alyhamdy879/bi-directional-visitor-counter/schematics/3D Visualization (back) .jpeg

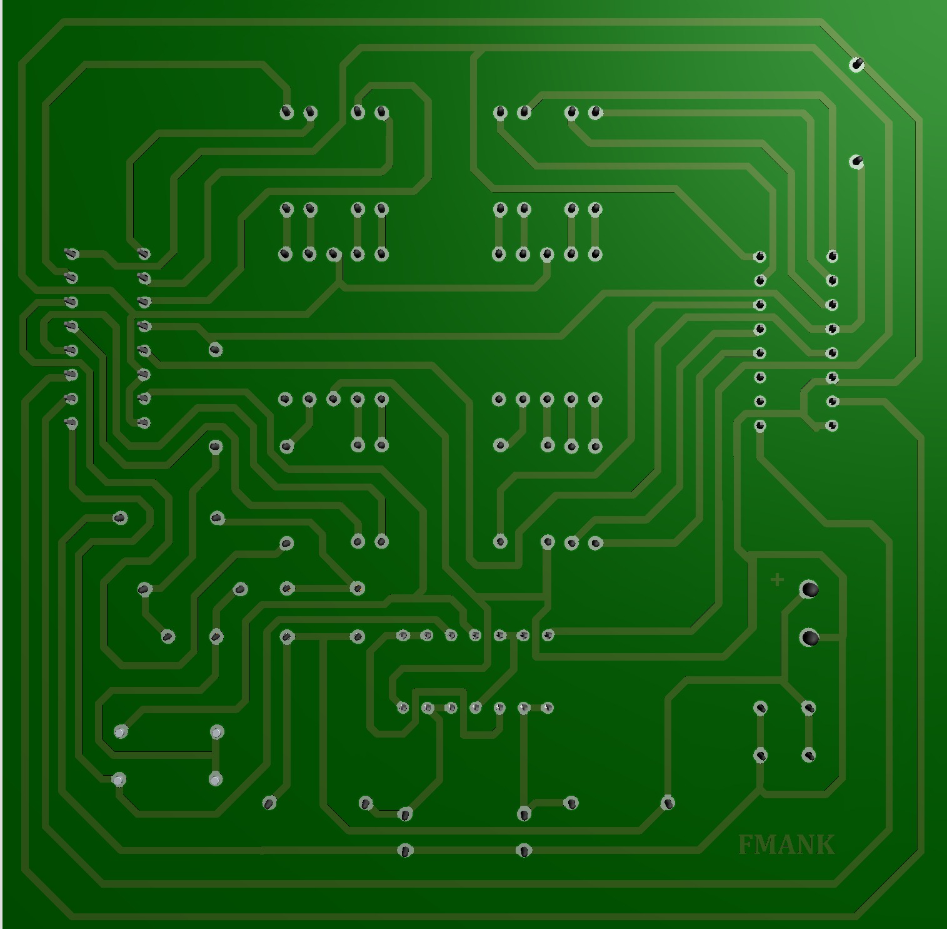
schematics/3D Visualization (back) .jpeg
