alyhamdy879/bi-directional-visitor-counter/schematics/3D Visualization (front).jpeg

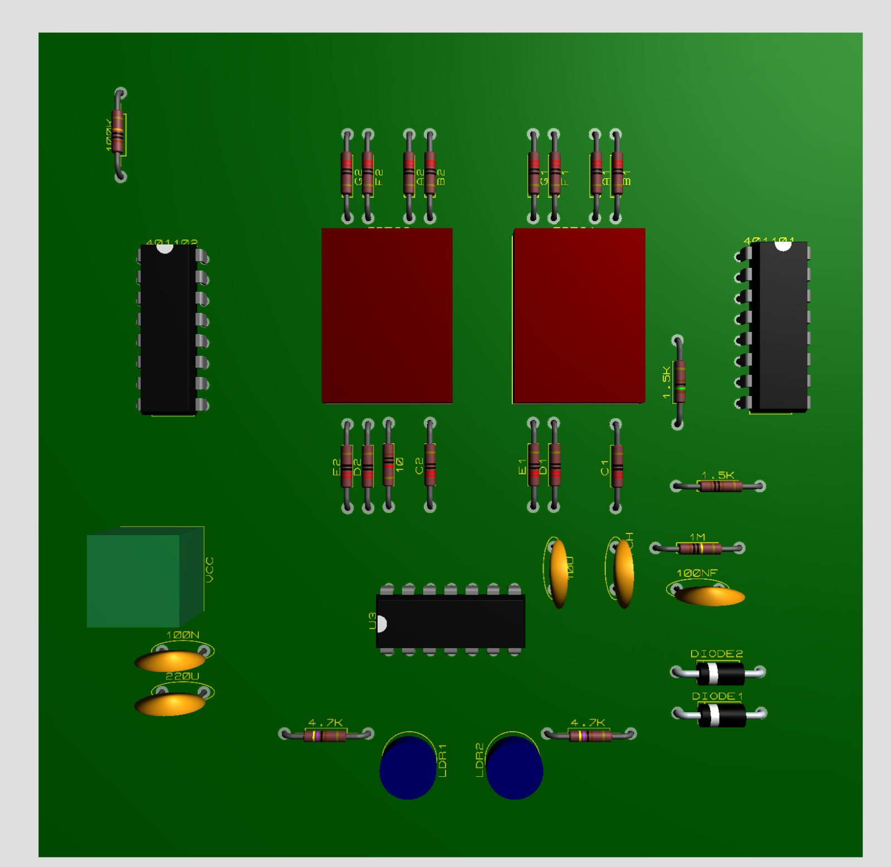
schematics/3D Visualization (front).jpeg
