alyhamdy879/bi-directional-visitor-counter/schematics/layout export .jpeg

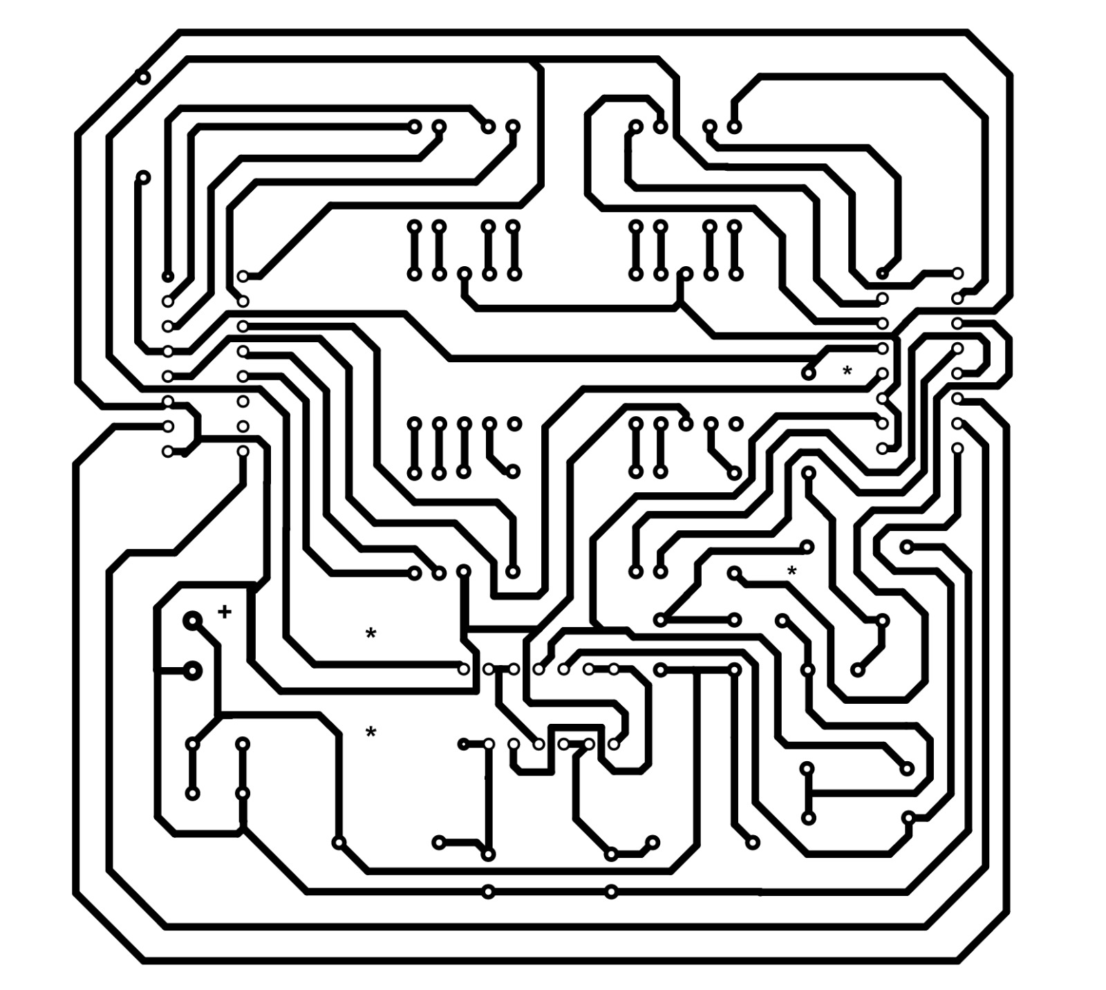
schematics/layout export .jpeg
