alyhamdy879/bi-directional-visitor-counter/schematics/schematic.jpeg

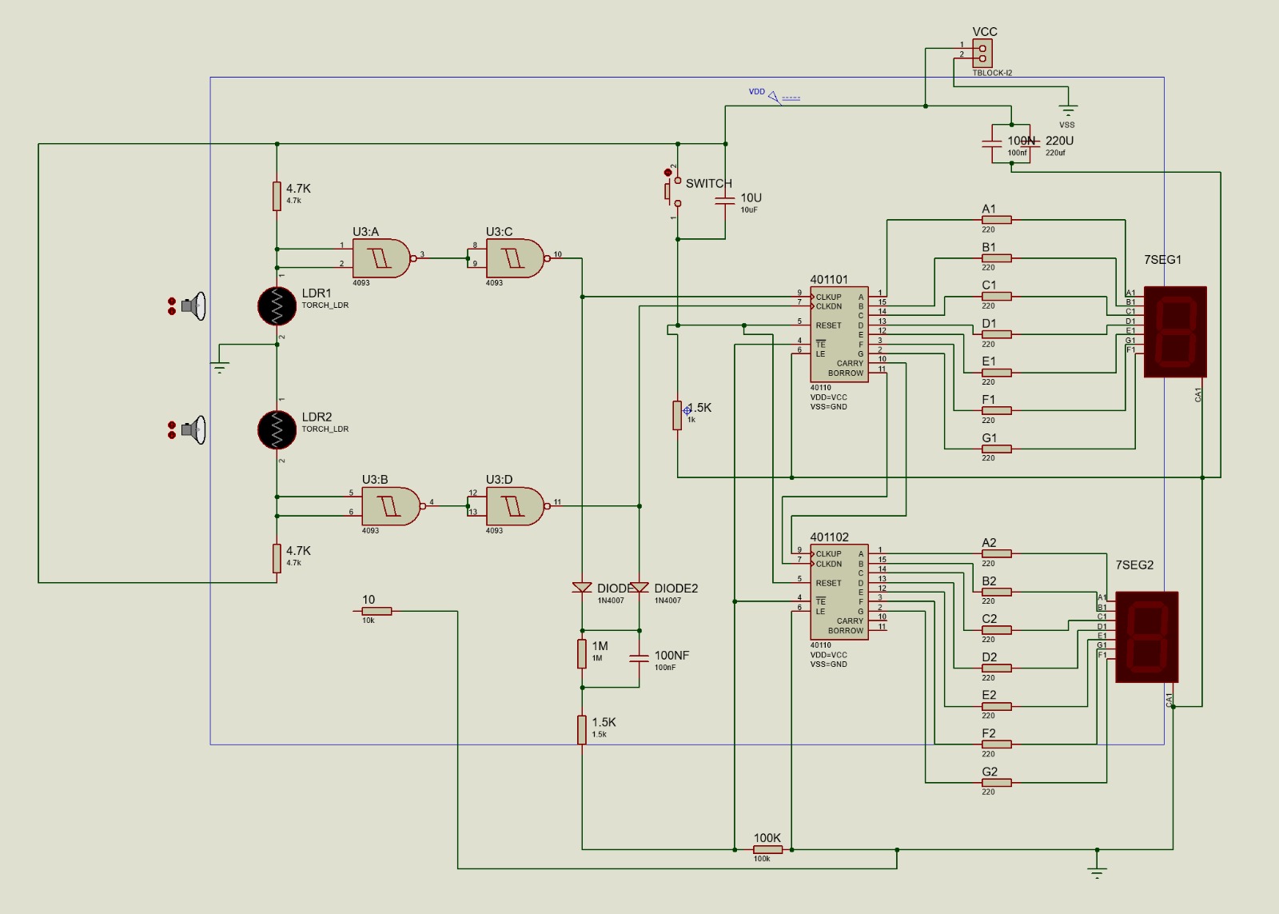
schematics/schematic.jpeg
