alyhamdy879/bi-directional-visitor-counter/(list of files, drawings)

Other design files:
simulation/visitor counter sim.pdsprj
