alyhamdy879/bi-directional-visitor-counter/(commit log)

2026-07-05 Rename WhatsApp Image 2026-07-05 at 4.24.42 AM.jpeg to media/PCB.jpeg
2026-07-05 Rename WhatsApp Image 2026-07-05 at 4.51.08 AM (1).jpeg to schematics/layout export .jpeg
2026-07-05 Rename WhatsApp Image 2026-07-05 at 4.51.04 AM.jpeg to schematics/3D Visualization (front).jpeg
2026-07-05 Rename WhatsApp Image 2026-07-05 at 4.51.08 AM.jpeg to schematics/3D Visualization (back) .jpeg
2026-07-05 Rename WhatsApp Image 2026-07-05 at 5.11.15 AM.jpeg to schematic.jpeg
2026-07-05 Fix image path for Proteus Circuit Schematic
